bartoszp1992/smokePID/doc/pcb/smokePID/additionals/LIB_WH1602L/WH1602L/3D/WH1602L.stp

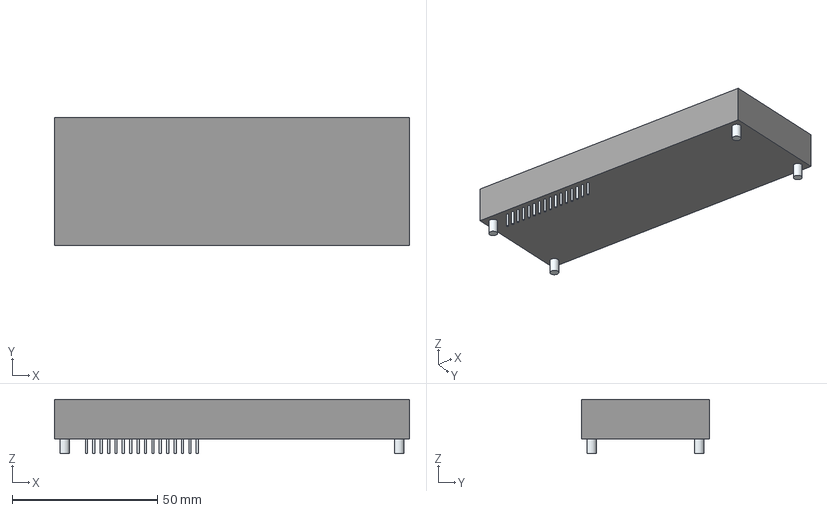
[picture p1: CAD file, 2023-06-16]
doc/pcb/smokePID/additionals/LIB_WH1602L/WH1602L/3D/WH1602L.stp
122.0 x 44.0 x 18.7 mm
Leads
