bartoszp1992/smokePID/doc/pcb/smokePID/additionals/PinSocket_1x16_P2.54mm_Vertical.step

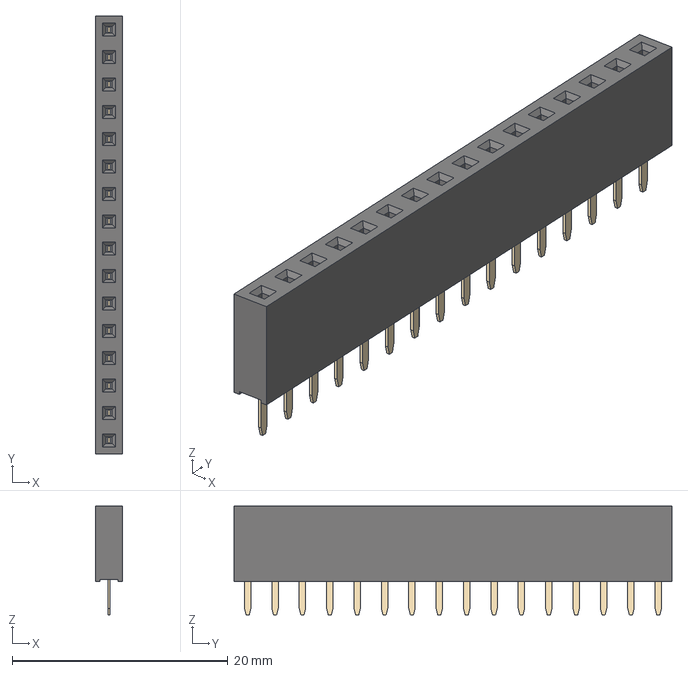
[picture p2: CAD file, 2023-06-16]
doc/pcb/smokePID/additionals/PinSocket_1x16_P2.54mm_Vertical.step
2.54 x 40.6 x 10.1 mm
