bartoszp1992/smokePID/(list of files, cad)

Other CAD files:
doc/pcb/smokePID/additionals/LIB_WH1602L/WH1602L/Allegro/wh1602l.psm
doc/pcb/smokePID/additionals/LIB_WH1602L/WH1602L/DEHDL/wh1602l/chips/chips.prt
