bartoszp1992/smokePID/(list of files, drawings)

Other design files:
doc/pcb/smokePID/additionals/LIB_WH1602L/WH1602L/Altium/WH1602L.PcbLib
doc/pcb/smokePID/additionals/LIB_WH1602L/WH1602L/Altium/WH1602L.SchLib
