bartoszp1992/smokePID/doc/pcb/smokePID/smokePID.kicad_pcb

## KiCad design doc/pcb/smokePID/smokePID.kicad_pcb (2023-06-16)

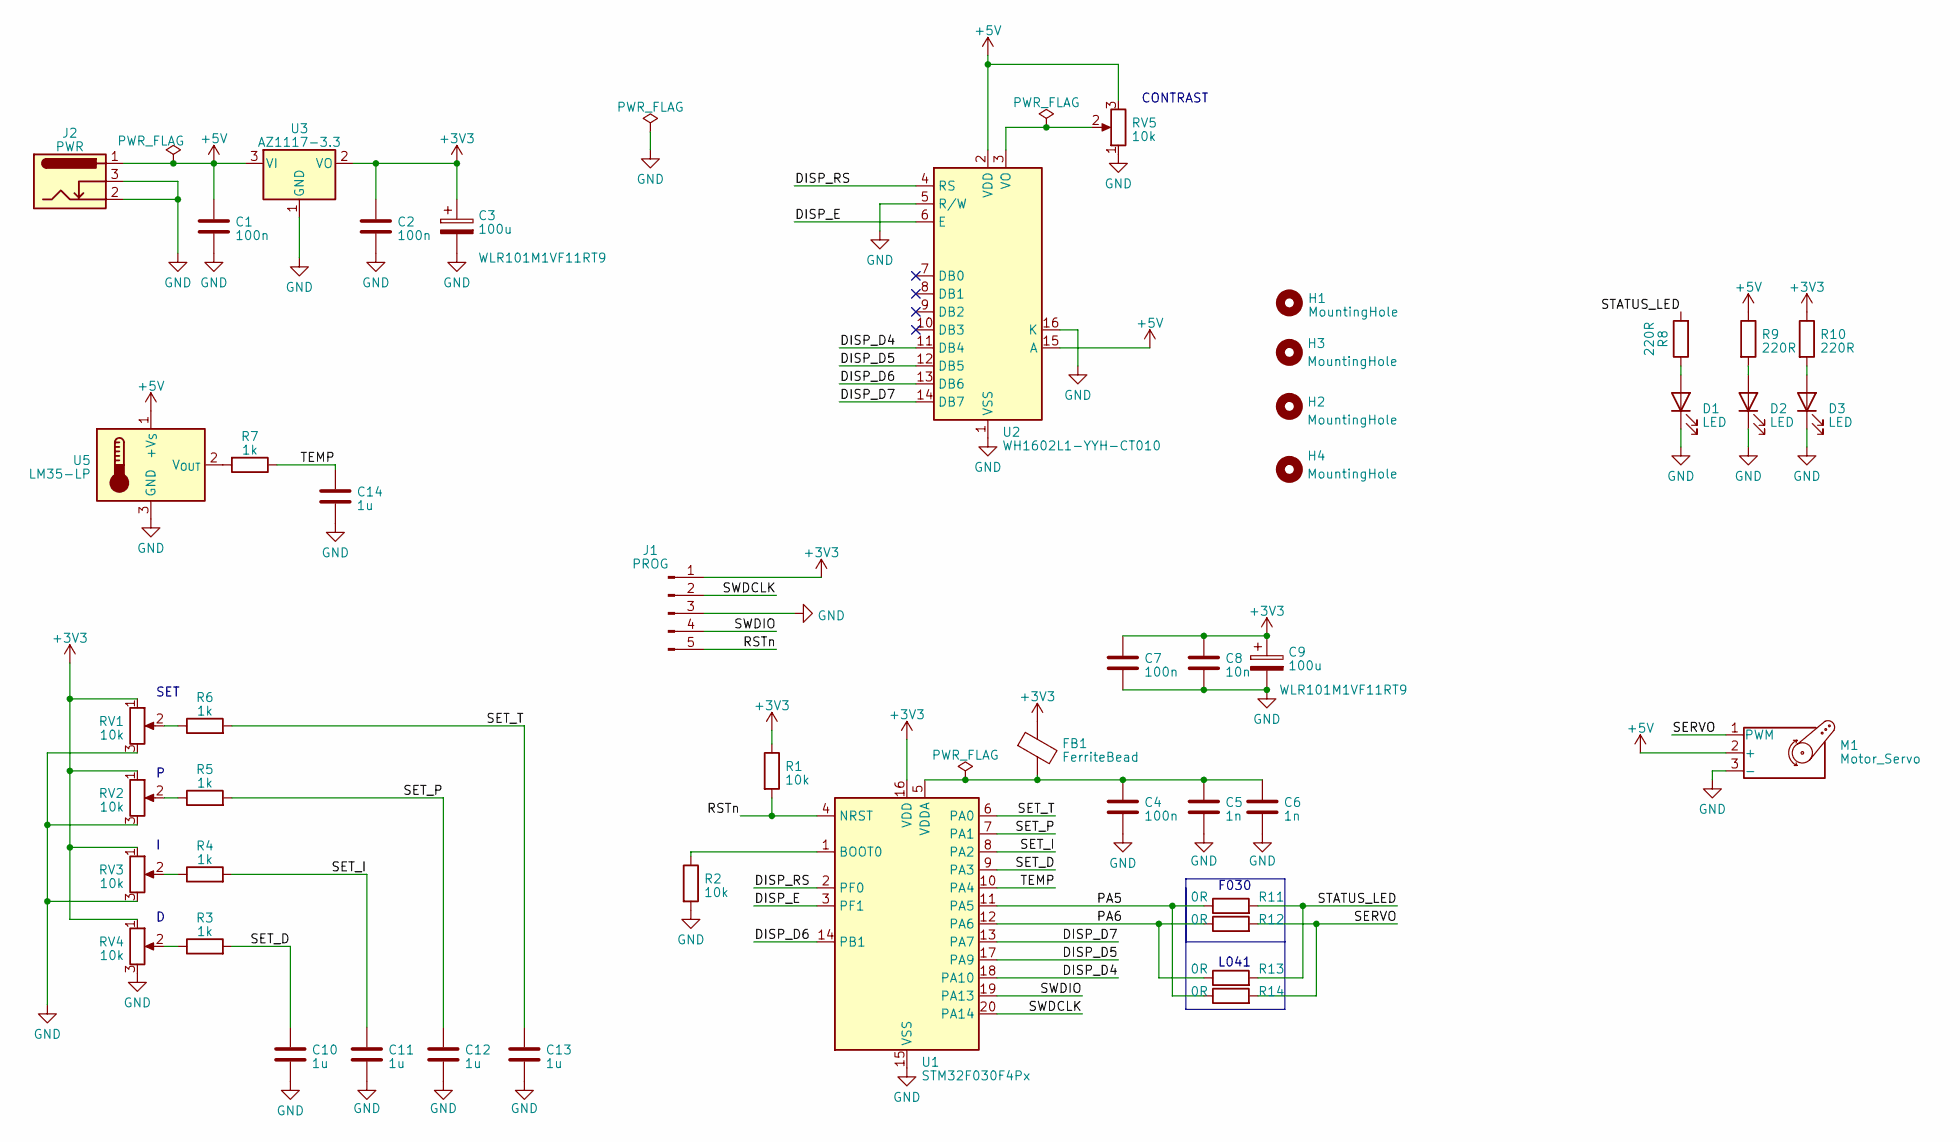
[picture p3: schematic smokePID.kicad_sch]

Parts:
C1, C2, C4, C7: 100n; C_0603_1608Metric
C3, C9: 100u; CP_Radial_D8.0mm_P3.50mm
C5, C6: 1n; C_0603_1608Metric
C8: 10n; C_0603_1608Metric
C10, C11, C12, C13, C14: 1u; C_0603_1608Metric
D1, D2, D3: LED; LED_0603_1608Metric
FB1: FerriteBead; L_0603_1608Metric
H1, H2, H3, H4: MountingHole; MountingHole_3.2mm_M3
J1: PROG; PinHeader_1x05_P2.54mm_Vertical
J2: PWR; BarrelJack_Horizontal
M1: Motor_Servo; PinHeader_1x03_P2.54mm_Vertical
R1, R2: 10k; R_0603_1608Metric
R3, R4, R5, R6, R7: 1k; R_0603_1608Metric
R8, R9, R10: 220R; R_0603_1608Metric
R11, R12, R13, R14: 0R; R_0603_1608Metric
RV1, RV2, RV3, RV4: 10k; Potentiometer_Alps_RK163_Single_Horizontal
RV5: 10k; Potentiometer_ACP_CA9-H5_Horizontal
U1: STM32F030F4Px; TSSOP-20_4.4x6.5mm_P0.65mm
U2: WH1602L1-YYH-CT010
U3: AZ1117-3.3; TO-252-2
U5: LM35-LP; PinHeader_1x03_P2.54mm_Vertical

Connections:
+3V3: C2.1, C3.1, C7.1, C8.1, C9.1, FB1.1, J1.1, R1.1, R10.1, RV1.1, RV2.1, RV3.1, RV4.1, U1.16 (VDD), U3.2 (VO)
+5V: C1.1, J2.1, M1.2 (+), R9.1, RV5.3, U2.2 (VDD), U2.15 (A), U3.3 (VI), U5.1 (+V_{S})
/DISP_D4: U1.18 (PA10), U2.11 (DB4)
/DISP_D5: U1.17 (PA9), U2.12 (DB5)
/DISP_D6: U1.14 (PB1), U2.13 (DB6)
/DISP_D7: U1.13 (PA7), U2.14 (DB7)
/DISP_E: U1.3 (PF1), U2.6 (E)
/DISP_RS: U1.2 (PF0), U2.4 (RS)
/PA5: R11.1, R14.1, U1.11 (PA5)
/PA6: R12.1, R13.1, U1.12 (PA6)
/RSTn: J1.5, R1.2, U1.4 (NRST)
/SERVO: M1.1 (PWM), R12.2, R14.2
/SET_D: C10.1, R3.2, U1.9 (PA3)
/SET_I: C11.1, R4.2, U1.8 (PA2)
/SET_P: C12.1, R5.2, U1.7 (PA1)
/SET_T: C13.1, R6.2, U1.6 (PA0)
/STATUS_LED: R8.2, R11.2, R13.2
/SWDCLK: J1.2, U1.20 (PA14)
/SWDIO: J1.4, U1.19 (PA13)
/TEMP: C14.1, R7.1, U1.10 (PA4)
GND: C1.2, C2.2, C3.2, C4.2, C5.2, C6.2, C7.2, C8.2, C9.2, C10.2, C11.2, C12.2, C13.2, C14.2, D1.1 (K), D2.1 (K), D3.1 (K), J1.3, J2.2, J2.3, M1.3 (-), R2.2, RV1.3, RV2.3, RV3.3, RV4.3, RV5.1, U1.15 (VSS), U2.1 (VSS), U2.5 (R/W), U2.16 (K), U3.1 (GND), U5.3 (GND)
unnamed: D1.2 (A), R8.1
unnamed: D2.2 (A), R9.2
unnamed: D3.2 (A), R10.2
unnamed: R3.1, RV4.2
unnamed: R4.1, RV3.2
unnamed: R5.1, RV2.2
unnamed: R6.1, RV1.2
unnamed: R2.1, U1.1 (BOOT0)
unnamed: C4.1, C5.1, C6.1, FB1.2, U1.5 (VDDA)
unnamed: RV5.2, U2.3 (VO)
unnamed: R7.2, U5.2 (V_{OUT})

Notes on the sheet:
CONTRAST
L041
F030
SET

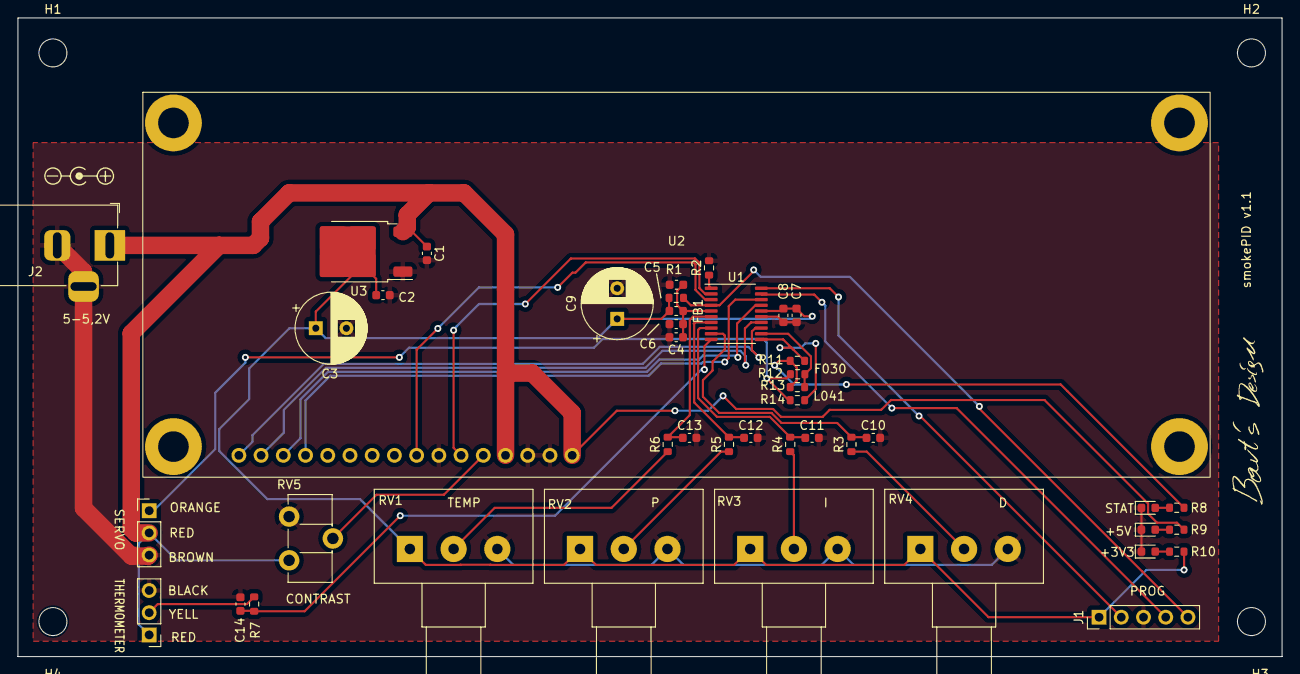
[picture p4: board smokePID.kicad_pcb from above]

Board: 2 copper layers, 144.5 x 73.0 mm, 48 parts (0 on the bottom side), 32 nets.
