bartoszp1992/smokePID/Core/Src/main.c

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
/* Includes ------------------------------------------------------------------*/
#include "main.h"

/* USER CODE BEGIN Includes */
#include "../Display/an_disp.h"
#include <math.h>
/* USER CODE END Includes */

ADC_HandleTypeDef hadc;
DMA_HandleTypeDef hdma_adc;

TIM_HandleTypeDef htim2;
TIM_HandleTypeDef htim21;

void SystemClock_Config(void);
static void MX_GPIO_Init(void);
static void MX_DMA_Init(void);
static void MX_ADC_Init(void);
static void MX_TIM2_Init(void);
static void MX_TIM21_Init(void);
/* USER CODE BEGIN 0 */

float conversionToMultiplier(uint16_t conversion, uint16_t maxMultiplier);
float conversionToTemperature(uint16_t conversion);
uint16_t conversionToServo(uint16_t reading);
int32_t PID(float targetValue, float currentValue, float *integralSum,
		float *lastError, uint32_t *Dcounter, float *xD, float Pmultiplier,
		float Imultiplier, float Dmultiplier);

uint32_t adcReadings[5];

float temperature;

uint32_t setPoint;

float amplificationP;
float amplificationI;
float amplificationD;

float integralSum;
float lastError;
uint32_t Dcounter;
float xD;

uint32_t throttle;

//resetowanie wyświetlacza co kilka sekund
volatile uint32_t displayRefreshCounter = 0;
volatile uint32_t displayRefreshDivider = 2000;
volatile uint8_t displayRefreshFlag = 0;


/* USER CODE END 0 */

/**
  * @brief  The application entry point.
  * @retval int
  */
int main(void)
{
  /* MCU Configuration--------------------------------------------------------*/

  /* Reset of all peripherals, Initializes the Flash interface and the Systick. */
  HAL_Init();

  /* Configure the system clock */
  SystemClock_Config();

  /* Initialize all configured peripherals */
  MX_GPIO_Init();
  MX_DMA_Init();
  MX_ADC_Init();
  MX_TIM2_Init();
  MX_TIM21_Init();
  /* USER CODE BEGIN 2 */

	//inicjalizacja wyświetlacza
	lcdInit();
	lcdLocate(4, 0);
	lcdStr("smokePID");
	lcdLocate(12, 1);
	lcdStr("v1.2");
	HAL_Delay(1000);

	//uruchomienie PWM
	HAL_TIM_PWM_Start(&htim2, TIM_CHANNEL_1);

	//test serwa
	lcdLocate(0, 1);
	lcdStr("MIN");
	__HAL_TIM_SET_COMPARE(&htim2, TIM_CHANNEL_1, 1000);
	HAL_Delay(1000);

	lcdLocate(0, 1);
	lcdStr("MAX");
	__HAL_TIM_SET_COMPARE(&htim2, TIM_CHANNEL_1, 2000);
	HAL_Delay(1000);

	lcdLocate(0, 1);
	lcdStr("MIN");
	__HAL_TIM_SET_COMPARE(&htim2, TIM_CHANNEL_1, 1000);
	HAL_Delay(1000);

	lcdClear();

	//kalibracja ADC
	HAL_ADCEx_Calibration_Start(&hadc, ADC_SINGLE_ENDED);

	//uruchomienie przetwornika
	HAL_ADC_Start_DMA(&hadc, adcReadings, 5);

	//uruchomienie niezależnego timera
	HAL_TIM_Base_Start_IT(&htim21);

  /* USER CODE END 2 */

  /* Infinite loop */
  /* USER CODE BEGIN WHILE */
	while (1) {

		//pokaż położenie przepustnicy
//		lcdLocate(8, 0);
//		if (throttle < 2000)
//			lcdInt((throttle - 1000) / 10);
//		else
//			lcdInt(99);
//		lcdStr(" ");

		//pokaż regulator
//		lcdLocate(6, 0);
//		lcdInt(xD);
//		lcdStr("  ");

		if(displayRefreshFlag){
			lcdInit();
			lcdClear();
			displayRefreshFlag = 0;
		}

		lcdLocate(6, 0);
		lcdStr(" PID");

		//pokaż zadaną temperaturę
		lcdLocate(0, 0);
		lcdInt(setPoint);
		lcdStr("stC ");

		//pokaż rzeczywistą temperaturę
		lcdLocate(11, 0);
		lcdInt((uint32_t) temperature);
		lcdStr("stC");

		//pokaż wzmocnienia regulatorów
		lcdLocate(0, 1);
		lcdFloat(amplificationP, 10);
		lcdStr(" ");

		lcdLocate(6, 1);
		lcdFloat(amplificationI, 100);
		lcdStr(" ");

		lcdLocate(12, 1);
		lcdFloat(amplificationD, 10);
		lcdStr(" ");

    /* USER CODE END WHILE */

    /* USER CODE BEGIN 3 */
	}

}

void HAL_TIM_PeriodElapsedCallback(TIM_HandleTypeDef *htim) {

	if (htim->Instance == TIM21) {
		//odświeżanie(reinicjalizacja) wyswietlacza(kasuje krzaki)
		displayRefreshCounter++;
		if(displayRefreshCounter >= displayRefreshDivider){
			displayRefreshFlag = 1;
			displayRefreshCounter = 0;
		}

		/*kanały ADC
		 * 0- ustawiona temperatura
		 * 1- wzmocnienie P
		 * 2- wzmocnienie I
		 * 3- wzmocnienie D
		 * 4- odczytana temperatura
		 */

		//test serwa i wejść adc
		//__HAL_TIM_SET_COMPARE(&htim2, TIM_CHANNEL_1,
		//conversionToServo(adcReadings[0]));

		//odczyt temperatury
		//różniczkowany
//		if (conversionToTemperature(adcReadings[4]) > temperature)
//			temperature = temperature + 0.01;
//		else if (conversionToTemperature(adcReadings[4]) < temperature)
//			temperature = temperature - 0.01;
		//bezpośredni
		temperature = conversionToTemperature(adcReadings[4]);

		//stała wartość
		//		temperature = 30.54;

		//odczyt zadanej temperatury
		setPoint = adcReadings[0] / 28;

		//odczyt wzmocnień
		amplificationP = conversionToMultiplier(adcReadings[1], 40);
		amplificationI = conversionToMultiplier(adcReadings[2], 10);
		amplificationD = conversionToMultiplier(adcReadings[3], 30);

		throttle = PID(setPoint, temperature, &integralSum, &lastError,
				&Dcounter, &xD, amplificationP, amplificationI, amplificationD)
				+ 1000;

		__HAL_TIM_SET_COMPARE(&htim2, TIM_CHANNEL_1, throttle);

	}

}

float conversionToMultiplier(uint16_t conversion, uint16_t maxMultiplier) {
	/*przelicz odczyt z potencjometru na mnożnik. Poniżej połowy- mnoznik ułamkowy.
	 Powyżej połowy- mnożnik całkowity o maksymalnej wartości maxMultiplier*/

	float reg;

	if (conversion < 2048) {
		reg = ((float) conversion * 1) / 2047;

	} else if (conversion >= 2048) {
		float conversion2 = (float) conversion - 2048;
		reg = ((maxMultiplier-1) * conversion2 / 2047) + 1;
	}
	return reg;
}

float conversionToTemperature(uint16_t conversion) {
	/*przelicz odczyt z termometru na temperaturę wg klucza 10mV/stC*/

	float temperature = (conversion * 3.3 / 4095) * 100;
	return temperature;
}

uint16_t conversionToServo(uint16_t reading) {
	return ((reading * 100) / 4095) + 100;
}

int32_t PID(float targetValue, float currentValue, float *integralSum,
		float *lastError, uint32_t *Dcounter, float *xD, float Pmultiplier,
		float Imultiplier, float Dmultiplier) {

	//obliczenie uchybu
	float currentError = targetValue - currentValue;

	//człon proporcjonalny
	float xP = currentError * Pmultiplier;

	//człon całkujący
	*integralSum = *integralSum + (currentError / 100);
	float xI = *integralSum * Imultiplier;

	//anty Wind-Up(blokada pętli całkowania)
	float antiWindUp = 1000;		//max windUp
	if (*integralSum >= antiWindUp && currentError > 0)
		*integralSum = antiWindUp;
	else if (*integralSum <= 0 - antiWindUp && currentError < 0)
		*integralSum = 0 - antiWindUp;
	//^ blokada ma zapobiec nieskończonemu wzrastaniu integralSum.

	//człon różniczkujący
	uint32_t Ddivider = 500;		//dzielnik opóźniający
	(*Dcounter)++;		//licznik wywołań funkcji PID
	if (*Dcounter >= Ddivider) {
		*xD = (currentError - *lastError) * Dmultiplier * 20; //-1
		*lastError = currentError;
		*Dcounter = 0;
	}
	//^Człon różniczkujący jest opóźniony, wykonuje się raz na divider wywołań funkcji.
	//potrzebuje do tego licznika(Dcounter), a xD jest zachowywane do następnego wywołania.

	//sumowanie korekt
	float sum = xP + xI + *xD;
	int32_t throttle = (int32_t) round(sum);

	int32_t maxThrottle = 1000;
	if (throttle > maxThrottle)
		throttle = maxThrottle;
	else if (throttle < 0)
		throttle = 0;

	return throttle;
  /* USER CODE END 3 */
}

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
