bartoszp1992/smokePID/smokePID.ioc

Mcu.UserName=STM32L041F6Px
PA0-CK_IN.GPIO_Label=SET
PA0-CK_IN.Signal=ADC_IN0
PA1.GPIO_Label=REG_P
PA1.Signal=ADC_IN1
PA10.GPIO_Label=DISP_D4
PA10.Signal=GPIO_Output
PA13.Signal=SYS_SWDIO
PA14.Signal=SYS_SWCLK
PA2.GPIO_Label=REG_I
PA2.Signal=ADC_IN2
PA3.GPIO_Label=REG_D
PA3.Signal=ADC_IN3
PA4.GPIO_Label=TEMP
PA4.Signal=ADC_IN4
PA5.GPIO_Label=SERVO
PA5.Signal=S_TIM2_CH1
PA6.GPIO_Label=LED_STATUS
PA6.Signal=GPIO_Output
PA7.GPIO_Label=DISP_D7
PA7.Signal=GPIO_Output
PA9.GPIO_Label=DISP_D5
PA9.Signal=GPIO_Output
PB1.GPIO_Label=DISP_D6
PB1.Signal=GPIO_Output
PC14-OSC32_IN.GPIO_Label=DISP_RS
PC14-OSC32_IN.Signal=GPIO_Output
PC15-OSC32_OUT.GPIO_Label=DISP_E
PC15-OSC32_OUT.Signal=GPIO_Output
