bartoszp1992/smokePID/Core/Inc/main.h

#define DISP_RS_Pin GPIO_PIN_14
#define DISP_RS_GPIO_Port GPIOC
#define DISP_E_Pin GPIO_PIN_15
#define DISP_E_GPIO_Port GPIOC
#define SET_Pin GPIO_PIN_0
#define SET_GPIO_Port GPIOA
#define REG_P_Pin GPIO_PIN_1
#define REG_P_GPIO_Port GPIOA
#define REG_I_Pin GPIO_PIN_2
#define REG_I_GPIO_Port GPIOA
#define REG_D_Pin GPIO_PIN_3
#define REG_D_GPIO_Port GPIOA
#define TEMP_Pin GPIO_PIN_4
#define TEMP_GPIO_Port GPIOA
#define SERVO_Pin GPIO_PIN_5
#define SERVO_GPIO_Port GPIOA
#define LED_STATUS_Pin GPIO_PIN_6
#define LED_STATUS_GPIO_Port GPIOA
#define DISP_D7_Pin GPIO_PIN_7
#define DISP_D7_GPIO_Port GPIOA
#define DISP_D6_Pin GPIO_PIN_1
#define DISP_D6_GPIO_Port GPIOB
#define DISP_D5_Pin GPIO_PIN_9
#define DISP_D5_GPIO_Port GPIOA
#define DISP_D4_Pin GPIO_PIN_10
#define DISP_D4_GPIO_Port GPIOA
