bartoszp1992/smokePID/(notices)

Notices in the files:
doc/pcb/smokePID/additionals/PinSocket_1x16_P2.54mm_Vertical.step:
Copyright (C) 2017, Terje Io
This work is licensed under the Creative Commons CC-BY-SA 4.0 License with the following exception:
To the extent that the creation of electronic designs that use 'Licensed Material'
https://creativecommons.org/licenses/by-sa/4.0/legalcode
Core/Inc/main.h:
© Copyright (c) 2021 STMicroelectronics.
All rights reserved.
This software component is licensed by ST under BSD 3-Clause license,
the "License"; You may not use this file except in compliance with the
License. You may obtain a copy of the License at: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
(C) COPYRIGHT STMicroelectronics *****END OF FILE
